Oblytoid/Monitoring-System-for-Black-Lion-Tamarins/docs/diagrams/activity-connect-gateway.png

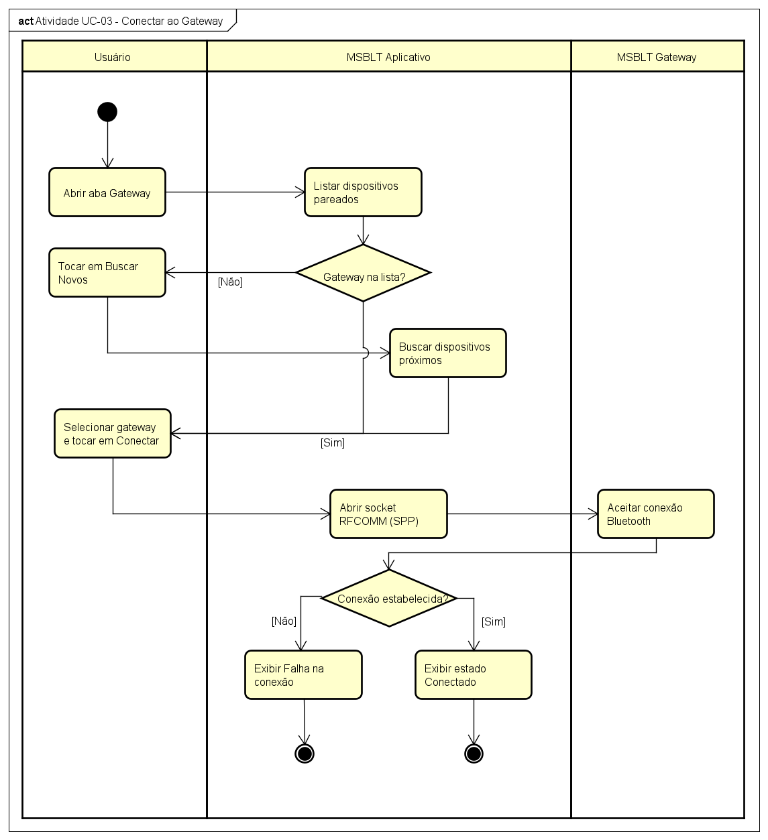
docs/diagrams/activity-connect-gateway.png
