Oblytoid/Monitoring-System-for-Black-Lion-Tamarins/docs/diagrams/activity-export-data.png

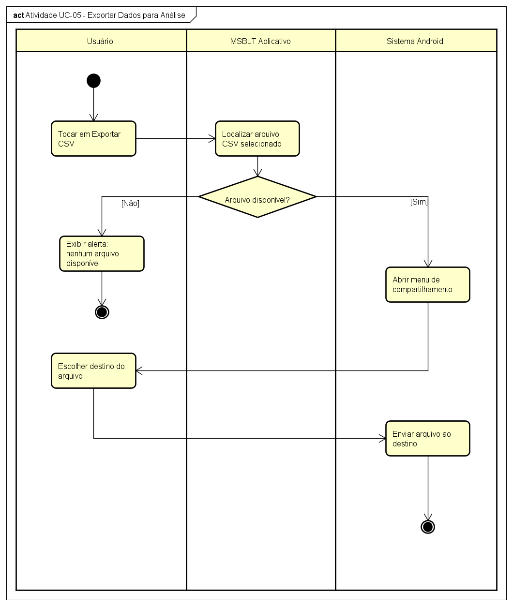
docs/diagrams/activity-export-data.png
