Oblytoid/Monitoring-System-for-Black-Lion-Tamarins/docs/diagrams/activity-filter-records.png

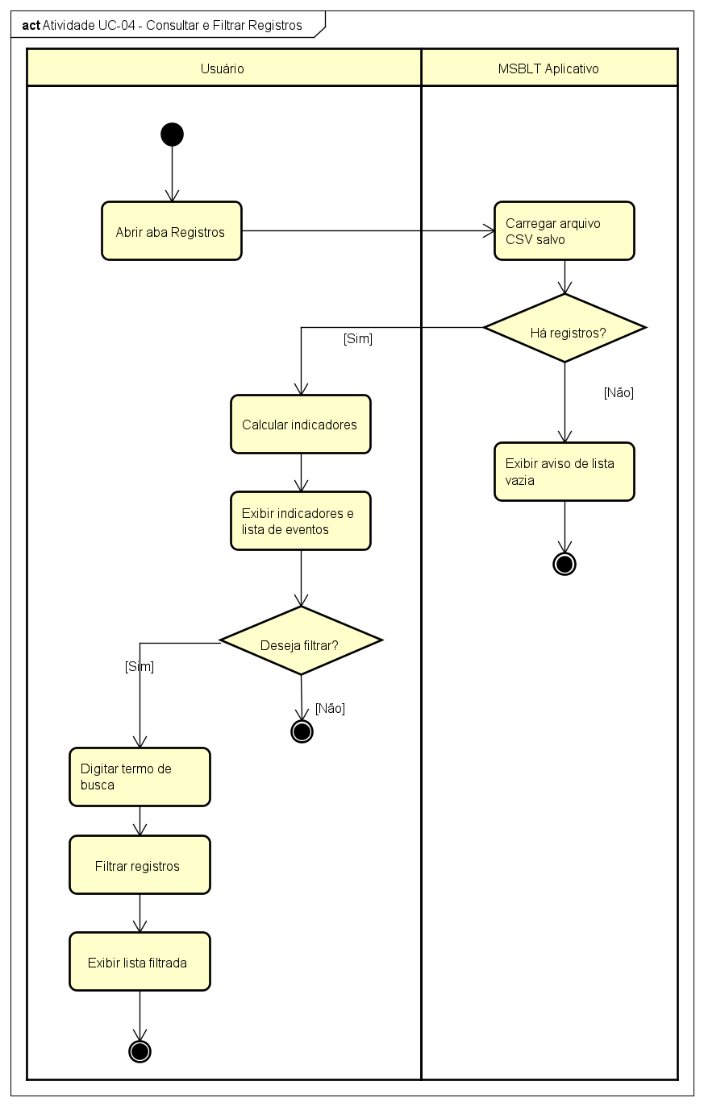
docs/diagrams/activity-filter-records.png
