Oblytoid/Monitoring-System-for-Black-Lion-Tamarins/docs/diagrams/activity-register-passage.png

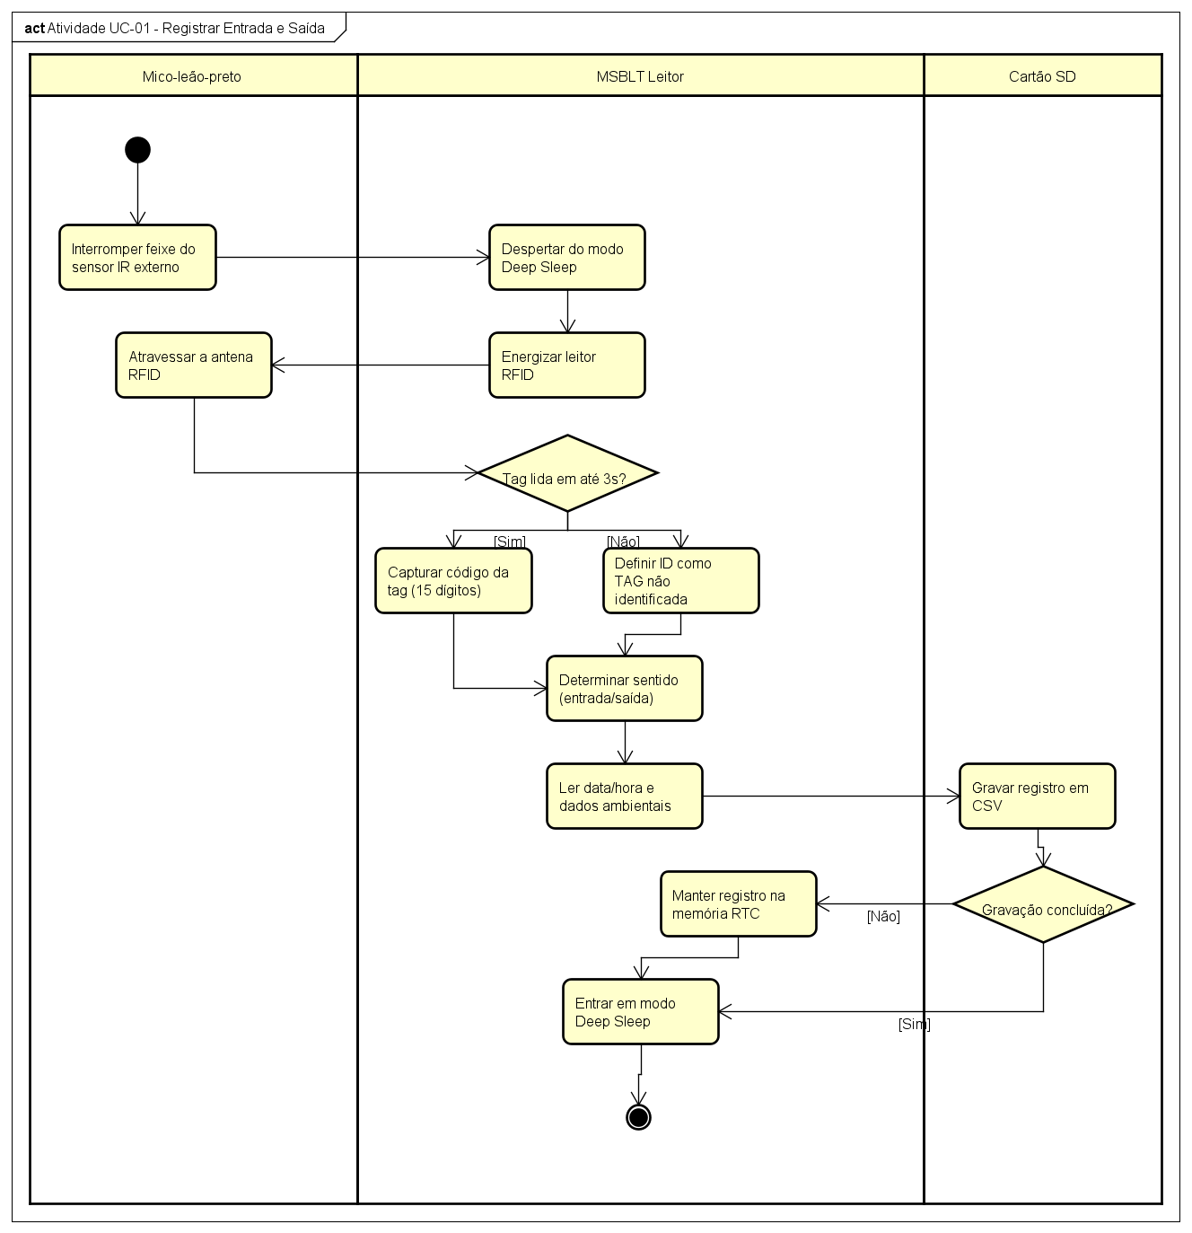
docs/diagrams/activity-register-passage.png
