Oblytoid/Monitoring-System-for-Black-Lion-Tamarins/docs/diagrams/activity-sync-data.png

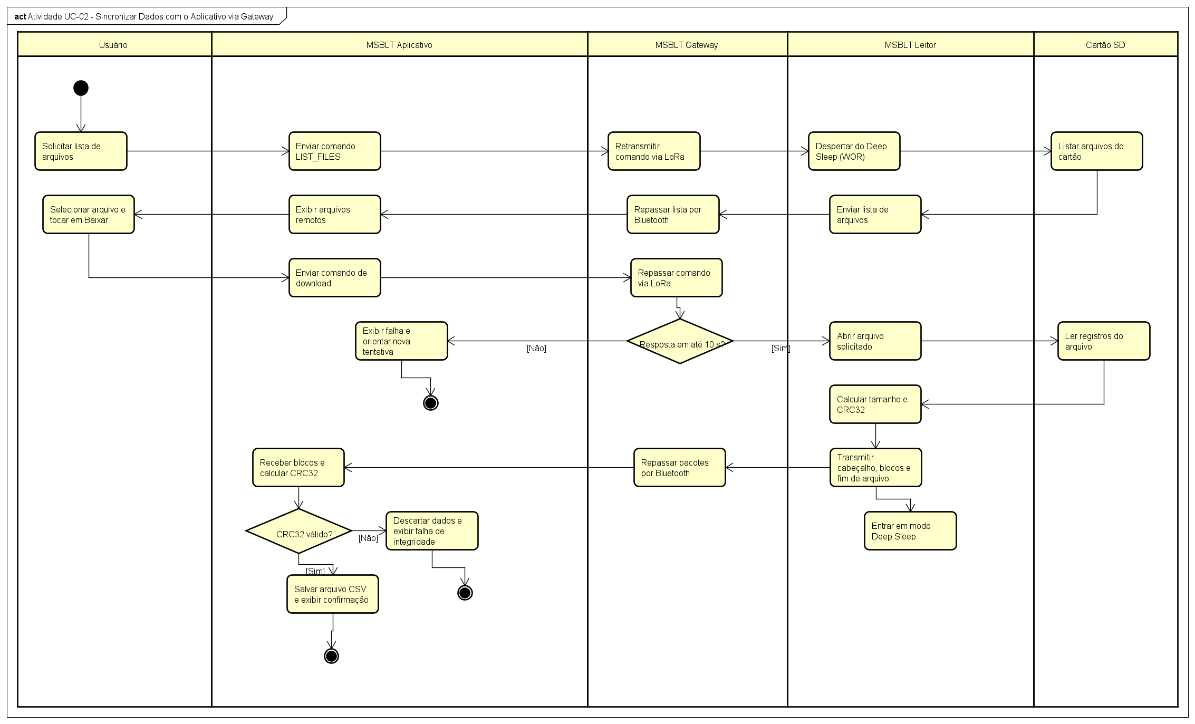
docs/diagrams/activity-sync-data.png
