Oblytoid/Monitoring-System-for-Black-Lion-Tamarins/docs/diagrams/class-diagram.png

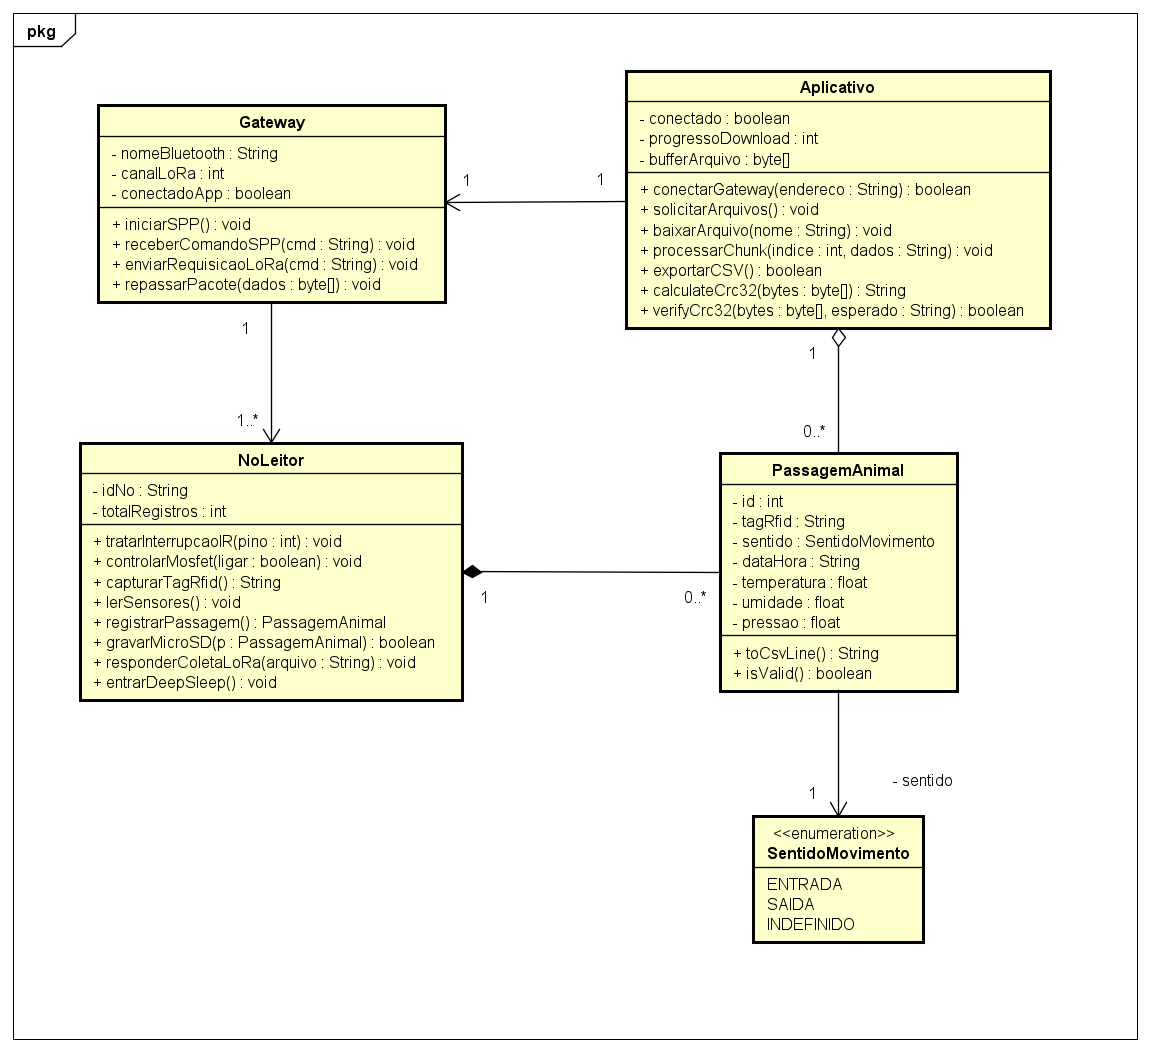
docs/diagrams/class-diagram.png
