Oblytoid/Monitoring-System-for-Black-Lion-Tamarins/docs/diagrams/reader-state-machine.png

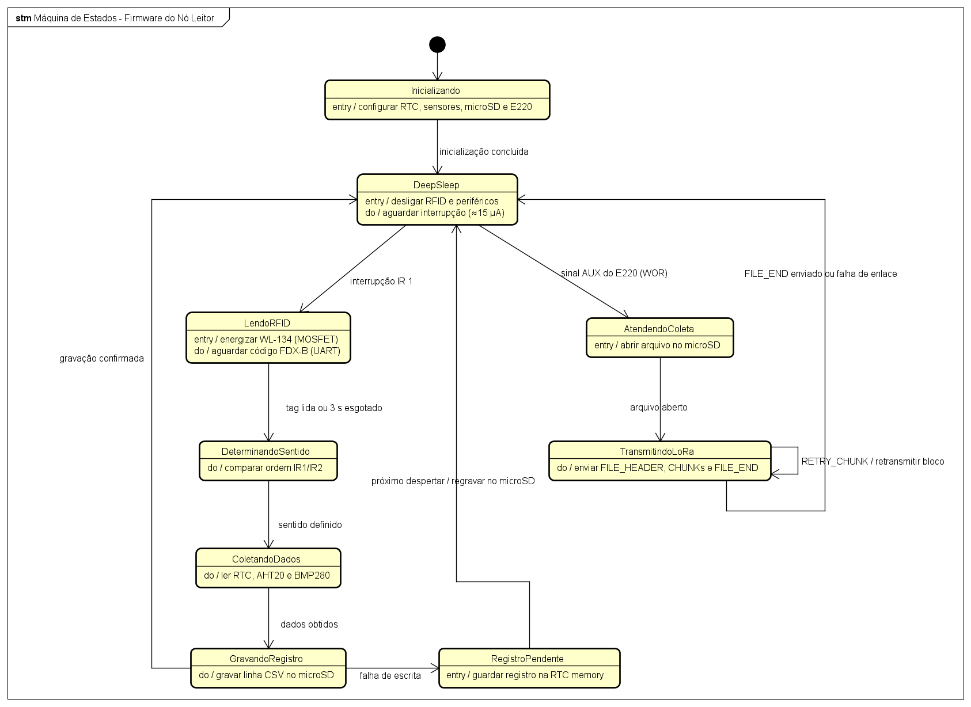
docs/diagrams/reader-state-machine.png
