Oblytoid/Monitoring-System-for-Black-Lion-Tamarins/docs/diagrams/sequence-connect-gateway.png

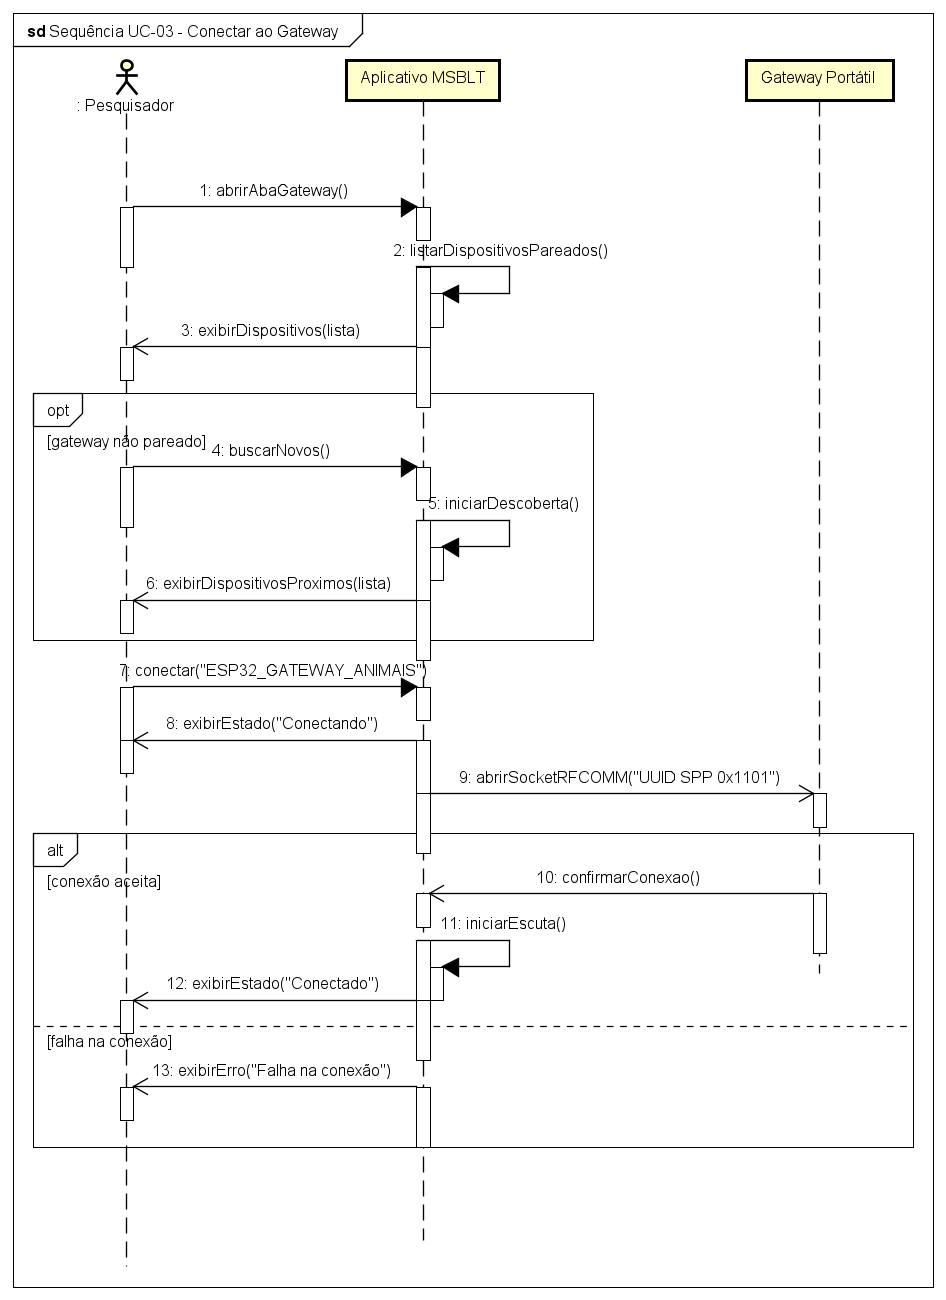
docs/diagrams/sequence-connect-gateway.png
