Oblytoid/Monitoring-System-for-Black-Lion-Tamarins/docs/diagrams/sequence-export-data.png

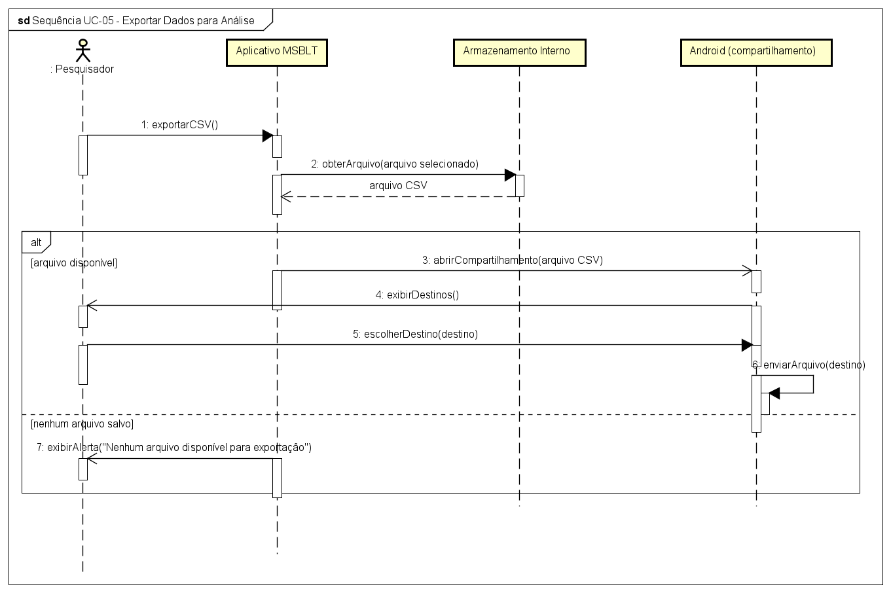
docs/diagrams/sequence-export-data.png
