Oblytoid/Monitoring-System-for-Black-Lion-Tamarins/docs/diagrams/sequence-filter-records.png

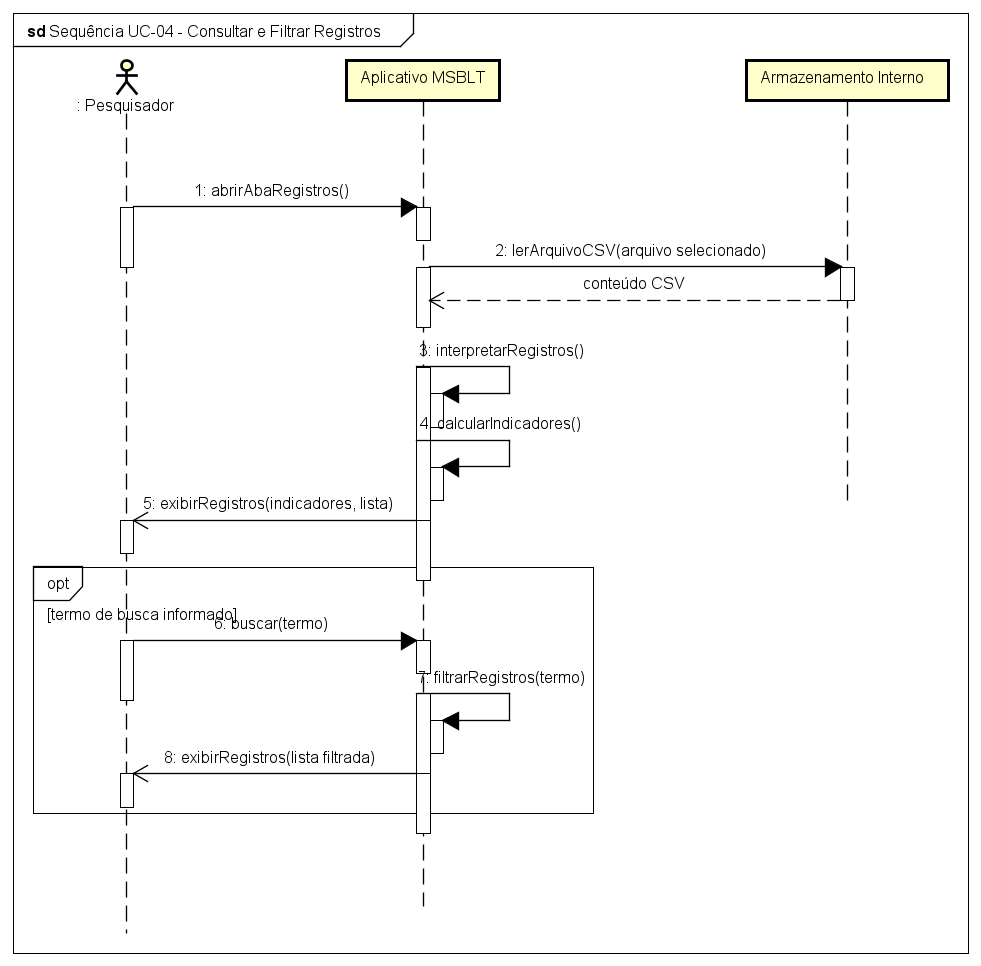
docs/diagrams/sequence-filter-records.png
