Oblytoid/Monitoring-System-for-Black-Lion-Tamarins/docs/diagrams/sequence-register-passage.png

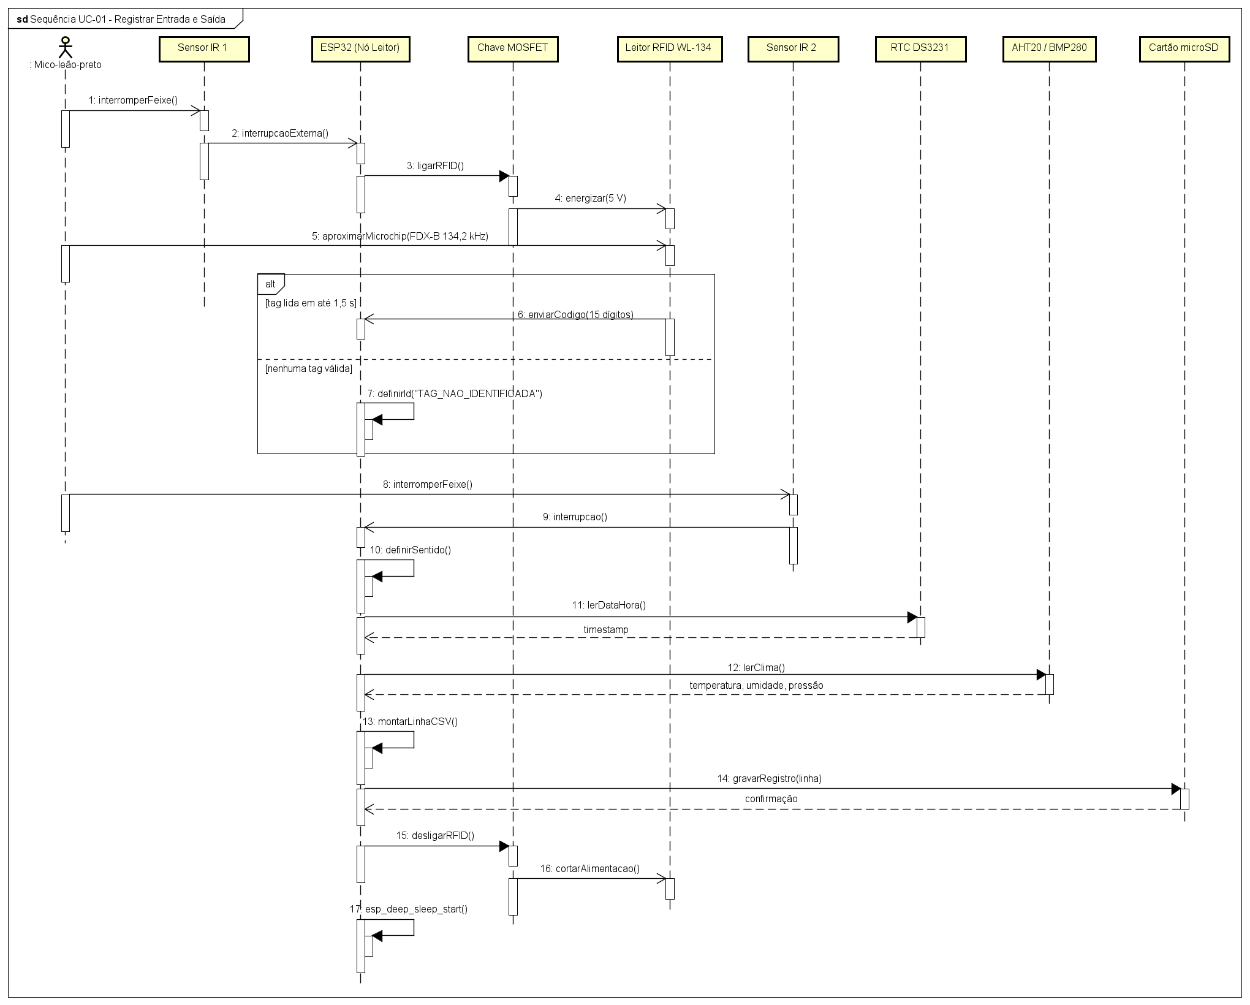
docs/diagrams/sequence-register-passage.png
