Oblytoid/Monitoring-System-for-Black-Lion-Tamarins/docs/diagrams/sequence-sync-data.png

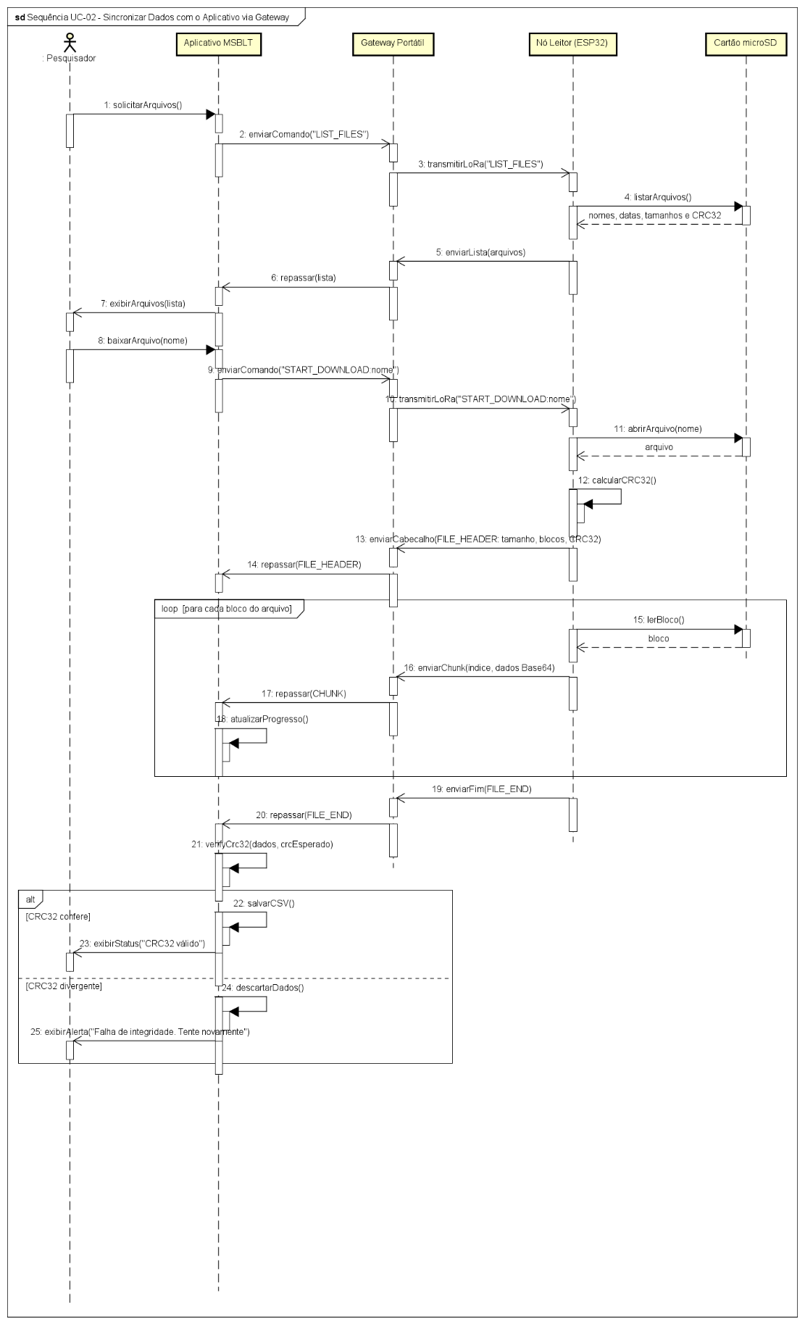
docs/diagrams/sequence-sync-data.png
