Oblytoid/Monitoring-System-for-Black-Lion-Tamarins/docs/diagrams/use-case.png

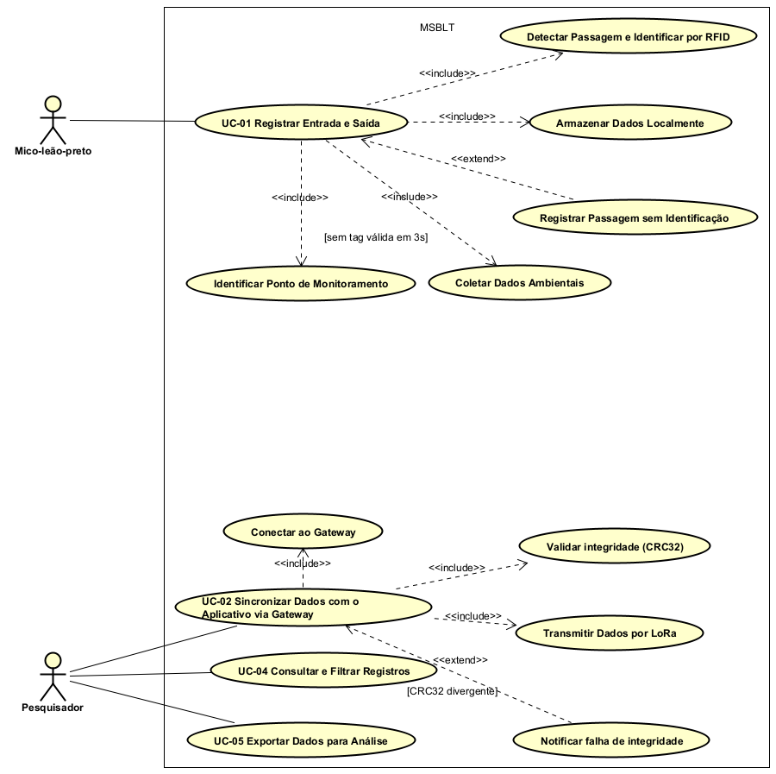
docs/diagrams/use-case.png
