Oblytoid/Monitoring-System-for-Black-Lion-Tamarins/hardware/reader-wiring-table.png

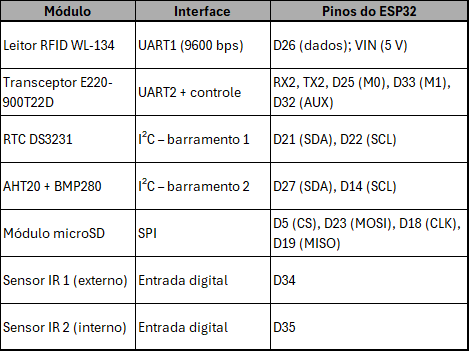
hardware/reader-wiring-table.png
