Oblytoid/Monitoring-System-for-Black-Lion-Tamarins/docs/images/test-results.png

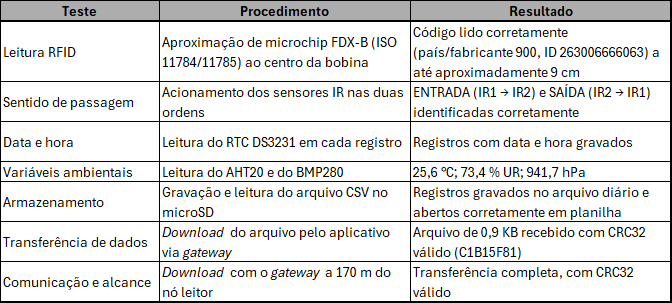
docs/images/test-results.png
