Oblytoid/Monitoring-System-for-Black-Lion-Tamarins/(commit log)

2026-11-02 feat(firmware): add reader node firmware (RFID, IR direction, sensors, microSD, LoRa)
2026-11-02 docs(hardware): add reader and gateway electrical schematics
2026-11-02 docs: add architecture, UML diagrams, prototype photos and app screenshots
